Robertbolt97/Claw-with-OT-2/OT-2 code/README.md

The files situated within in this folder are the ones that are loaded onto jupyter notebook of opentrons OT-2 and are split into three sections; grabbing, releasing and overall code

Overall scipting (utilising grabbing and releasing scripts):
1) Movement_trial_empty
2) Movement_trial_heavy
3) Movement_trial_heavy_height
4) Claw_falcon_tube

Grabbing Scripts:
1) Claw_grab_light
2) Claw_grab_heavy
3) Claw_grab_heavy_height

Releasing Scripts
1) Claw_release
2) Claw_release_heavy
