Robertbolt97/Claw-with-OT-2/Labware Weights.pdf

# Labware Weights: Empty and Filled

Labware | Empty Weight / g | Full Weight / g
Corning 96 Well Plate 360 µL Flat | 42 | 77
Thermo Scientific Nunc 96 Well Plate 1300 µL | 100 | 210
NEST 12 Well Reservoir 15 mL | 79 | 248
Tip rack 20 uL | 168 | 173
Tip rack 300 uL | 162 | 209
Agilent 1 Well Reservoir 290 mL (225 mL) | 53 | 286
Custom 24 x LCMS vials | 61 | 163
