Robertbolt97/Claw-with-OT-2/Bill of materials table.pdf

# Bill of materials table

Part No. | Part Name | Quantity | Category | Cost/£ | Source
1 | Raspberry pi zero wh | 1 | Microcontroller | 12.60 | Onecall - Farnell
2 | Servo HAT | 1 | Servo motor module | 12.99 | Amazon
3 | Servo Motor | 2 | Servo motor | 8.28 | Onecall - Farnell
4 | Servo Extension Cable Cord | 1 | Servo motor extension wire | 9.99 | Amazon
5 | Servo Plug Male Female Connector Crimp Pin Kit | 1 | Servo motor extension wire | 8.99 | Amazon
6 | USB To TTL RS232 Module Converter | 1 | Serial adapter | 6.99 | Amazon
7 | None slip tape | 1 | Grip tape for claw | 6.28 | Amazon
8 | 3D filament (750 g / 96 m) | 1 | PLA for print of the claw design | 33.67 / (13.51)* | Onecall - Farnell
9 | Hex Socket Button Screw | 4 | M3 x 8 mm | 0.20 | Onecall - Farnell
10 | Hex Socket Button Screw | 4 | M3 x 6 mm | 0.44 | RS Pro
11 | Square nut | 8 | M3 | 0.72 | Onecall - Farnell
12 | Self-tapping screws | 2 | 4 x 3/8" (2.9 x 9.5mm) | 0.12 | RS Pro
13 | Self-tapping screws | 2 | 4 x 1/2" (2.9 x 13mm) | 0.17 | RS Pro
14 | Pan head slotted screw | 1 | M3 x 20 mm | 0.03 | Onecall - Farnell
15 | Hex nut | 1 | M3 | 0.03 | Onecall - Farnell

Total Cost = £101.50 (£81.34)*

*Cost of filament used

# Links for Consumptions

Raspberry pi: RASPBERRY-PI ZERO WH V2 (https://uk.farnell.com/raspberry-pi/sc0721/rpi-zero-2w-brd-w-header-arm-cortex/dp/4531088)

Servo HAT: Waveshare Servo Driver HAT Expansion Board, Compatible with Raspberry Pi, 12-Bit, I2C Interface, Straight Pinheader, Up to 16-Channel Servo/PWM Outputs (https://www.amazon.co.uk/Waveshare-16-Channel-Servo-Driver-HAT/dp/B07GYFTKZD)

Servo Motor: Servo Motor, Continuous Rotation (https://uk.farnell.com/multicomp-pro/mp-708-0002/servo-motor-6v-130rpm-360deg-rotation/dp/3359812)

Servo Extension Cable: Servo Extension Cable Cord Connector Lead Wire 22AWG Servo Receiver Wire (https://www.amazon.co.uk/sourcing-map-Extension-Connector-Receiver/dp/B09BQVJHM5)

Servo Plug Male Female Connector Crimp Pin Kit: 30 Sets Servo Plug Male Female Connector Crimp Pin Kit Compatible Futaba for Hitec Spektrum RC (https://www.amazon.co.uk/Female-Connector-Compatible-Futaba-Spektrum/dp/B07PJK2WGX)

USB To TTL RS232 Module Converter: USB To TTL Serial Port Download Cable (https://www.amazon.co.uk/Serial-Download-PL2303TA-Converter-Adapter/dp/B08HS9M3P9)

None slip tape: 1 Roll Clear Anti Slip Tape Non Slip Safety Grip Tape Rubber Self Adhesive Tape (https://www.amazon.co.uk/Safety-Adhesive-Bathtub-Kitchen-Without/dp/B0DDC31DG3)

3D filament: 3D Printer Filament, 2.85mm Dia, Black, PLA, 145 to 160°C, 750 g (https://uk.farnell.com/ultimaker/202300/3d-printer-filament-pla-2-85mm/dp/2992600)

Hex Socket Button Screw (M3 x 8 mm): Socket Screw, Button Head Hex, Stainless Steel A2, 8 mm, M3 (https://uk.farnell.com/tr-fastenings/m38-bha2mcs100/screw-button-head-hex-socket-ss/dp/1420715)

Hex Socket Button Screw (M3 x 6 mm): RS PRO Black, Self-Colour Steel Hex Socket Button Screw, ISO 7380, M3 x 6mm (https://uk.rs-online.com/web/p/socket-screws/8229098?gb=s)

Square nut (M3): Press Nut, Square, Bright Zinc Plated, M3 (https://uk.farnell.com/tr-fastenings/m3-sqst-z100bs4183/press-nut-square-bzp-m3-pk100/dp/1419469?cfm=true)

Self-tapping screws - 4 x 3/8": RS PRO Plain Stainless Steel Pan Head Self Tapping Screw, N°4 x 3/8in Long 9.5mm Long (https://uk.rs-online.com/web/p/self-tapping-screws/0521541?gb=s)

Self-tapping screws - 4 x 1/2": RS PRO Plain Stainless Steel Pan Head Self Tapping Screw, N°4 x 1/2in Long 13mm Long (https://uk.rs-online.com/web/p/self-tapping-screws/0521557?gb=s)

Pan head slotted screw (M3 x 20 mm): M3 x 20mm Slotted Countersunk Head ZP Machine Screws (https://cpc.farnell.com/unbranded/cs3m20/screw-csk-slot-3m-x-20mm-100pk/dp/FNCS3M20?gad_source=1)

Hex nut (M3): Hex Nut, Stainless Steel A2, M3 (https://uk.farnell.com/multicomp-pro/mp007412/nut-hex-stainless-steel-a2-m3/dp/3755189)
