Robertbolt97/Claw-with-OT-2/CAD_Files/9)Slider-main_body_gear.stl

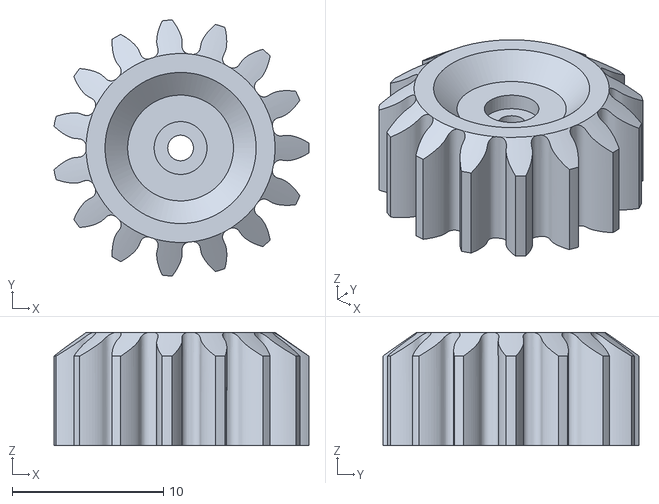
[picture p6: CAD file, 2025-03-10]
CAD_Files/9)Slider-main_body_gear.stl
16.9 x 17.0 x 7.50
