Robertbolt97/Claw-with-OT-2/CAD_Files/11) Front_main_body.stl

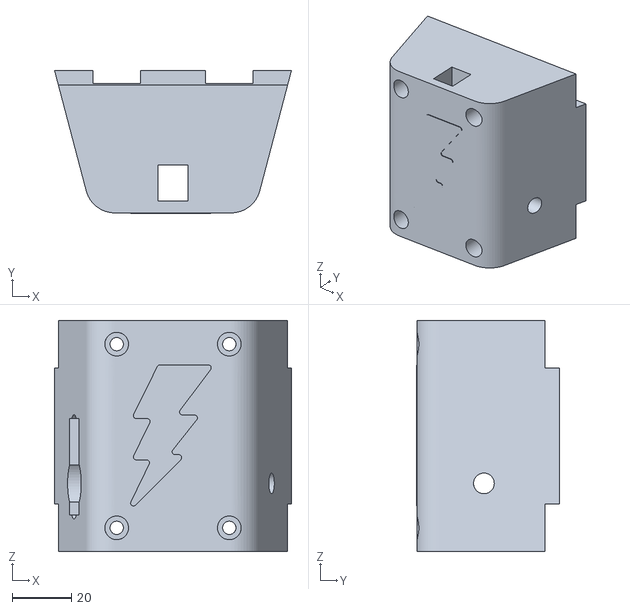
[picture p7: CAD file, 2025-03-10]
CAD_Files/11) Front_main_body.stl
80.0 x 48.4 x 78.0
