Robertbolt97/Claw-with-OT-2/CAD_Files/4)Slider_main_body.stl

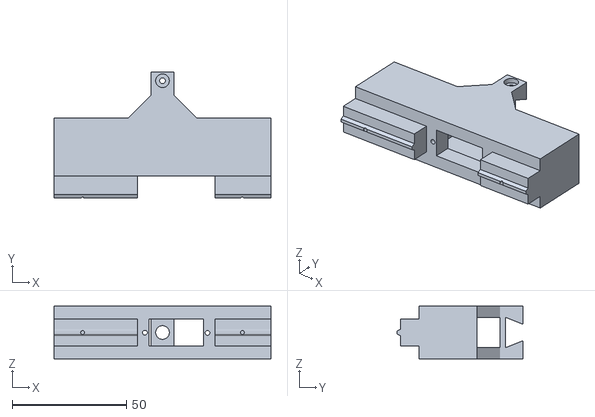
[picture p8: CAD file, 2025-03-10]
CAD_Files/4)Slider_main_body.stl
95.0 x 55.0 x 23.0
