Robertbolt97/Claw-with-OT-2/CAD_Files/6)Front_Slider.stl

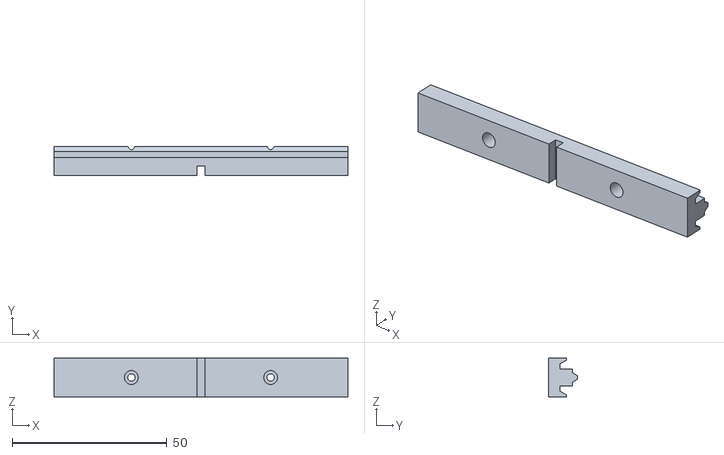
[picture p9: CAD file, 2025-03-10]
CAD_Files/6)Front_Slider.stl
95.0 x 9.25 x 12.5
