Robertbolt97/Claw-with-OT-2/CAD_Files/1)Support_bracket_brace.stl

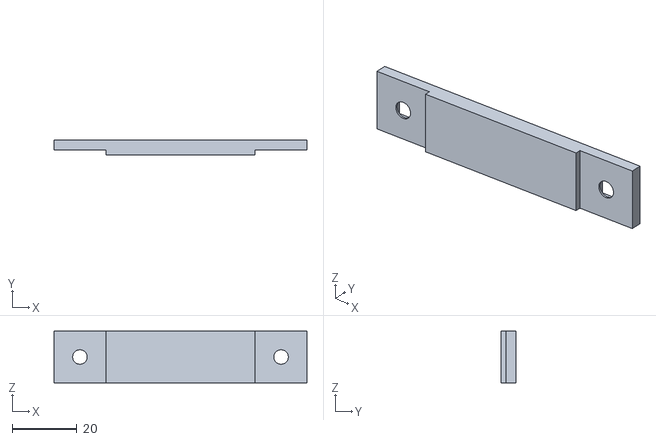
[picture p10: CAD file, 2025-03-10]
CAD_Files/1)Support_bracket_brace.stl
78.0 x 4.50 x 16.0
