Robertbolt97/Claw-with-OT-2/CAD_Files/10)Lowering_arm_gear.stl

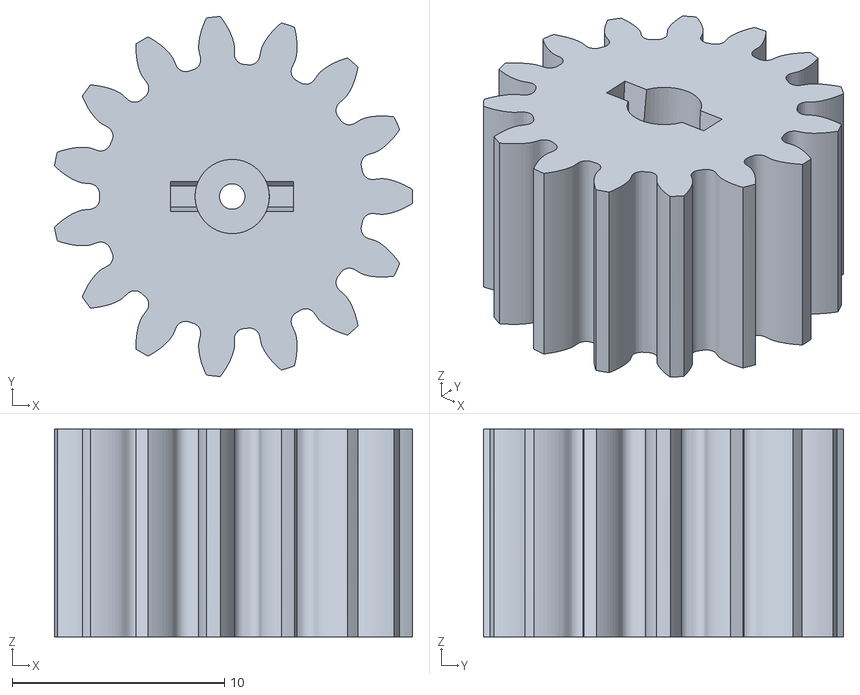
[picture p11: CAD file, 2025-03-10]
CAD_Files/10)Lowering_arm_gear.stl
16.9 x 17.0 x 9.80
