Robertbolt97/Claw-with-OT-2/CAD_Files/2)Support_bracket.stl

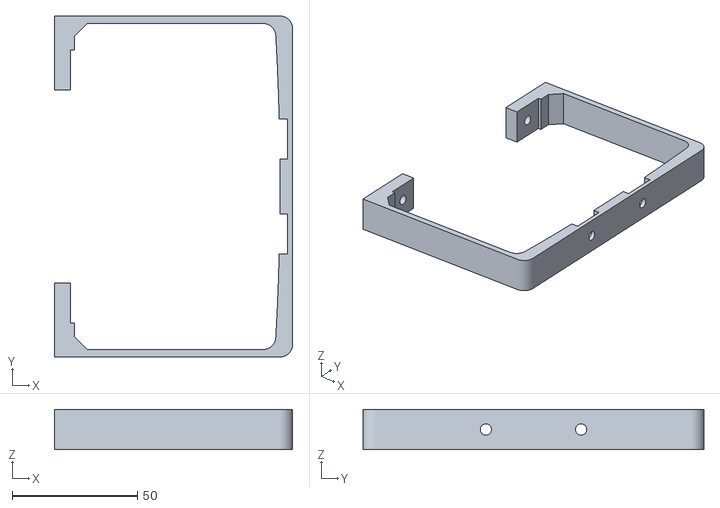
[picture p12: CAD file, 2025-03-10]
CAD_Files/2)Support_bracket.stl
95.0 x 136.0 x 16.0
