Robertbolt97/Claw-with-OT-2/CAD_Files/5)Back_slider.stl

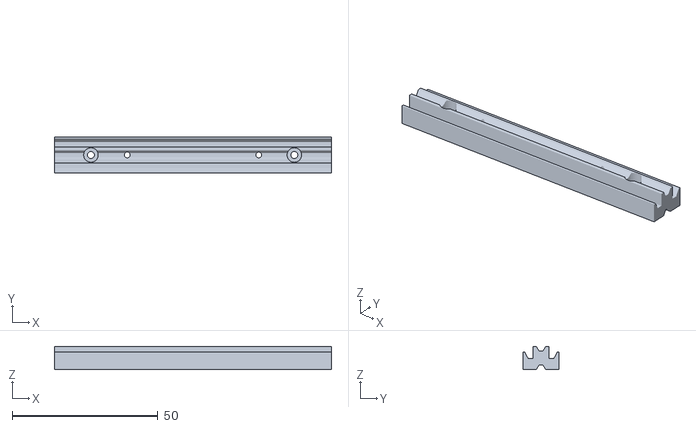
[picture p13: CAD file, 2025-03-10]
CAD_Files/5)Back_slider.stl
95.0 x 12.5 x 8.00
