Robertbolt97/Claw-with-OT-2/CAD_Files/8)Stopper.stl

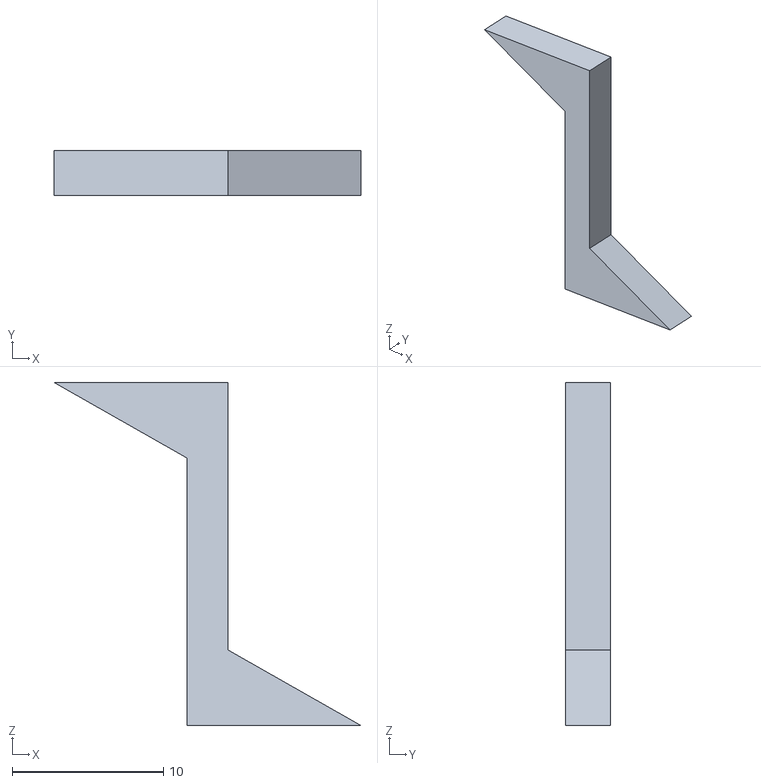
[picture p14: CAD file, 2025-03-10]
CAD_Files/8)Stopper.stl
20.3 x 3.00 x 22.7
