Robertbolt97/Claw-with-OT-2/CAD_Files/3)Lowering_arm.stl

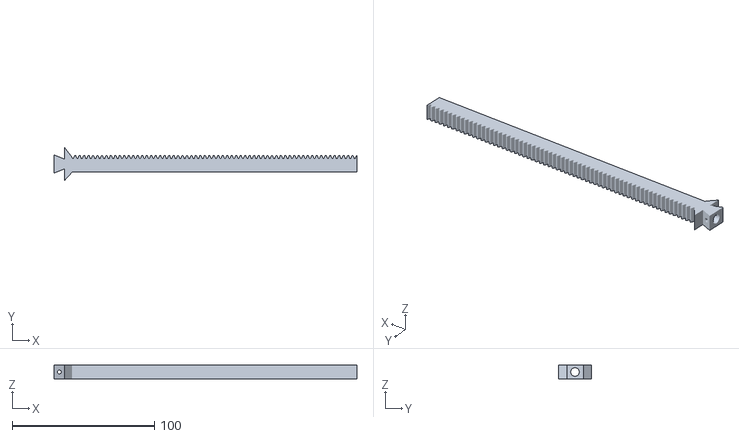
[picture p15: CAD file, 2025-03-10]
CAD_Files/3)Lowering_arm.stl
212.8 x 23.0 x 10.0
