Robertbolt97/Claw-with-OT-2/CAD_Files/7)Sliding_fork_reinforce.stl

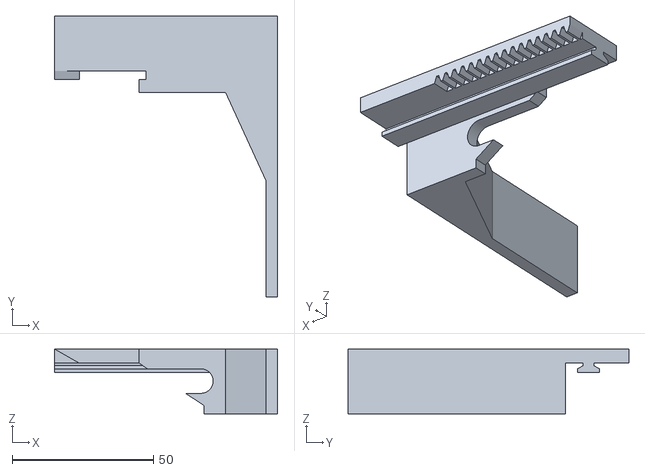
[picture p16: CAD file, 2025-03-10]
CAD_Files/7)Sliding_fork_reinforce.stl
79.0 x 99.5 x 23.0
