Robertbolt97/Claw-with-OT-2/Images/Step_5A.jpg

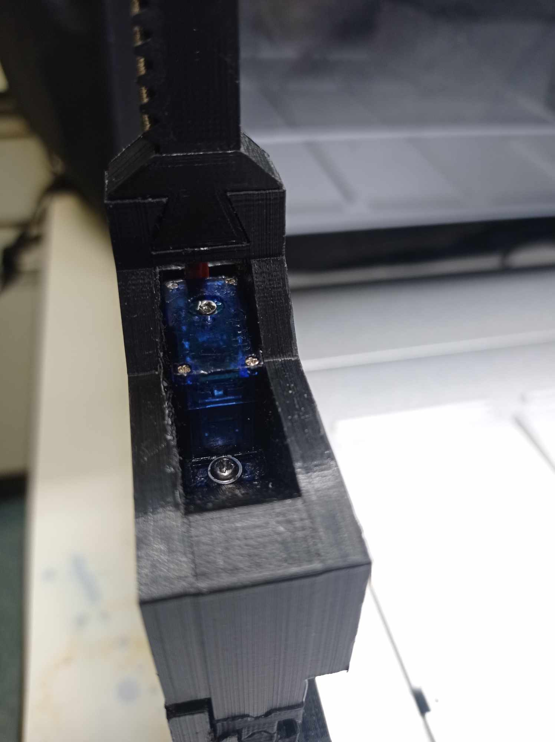
Images/Step_5A.jpg
