Robertbolt97/Claw-with-OT-2/(commit log)

2025-03-10 Create 3D printing files
2025-03-10 Update and rename 3D printing files to README.md
2025-03-10 Rename Claw numbered.jpg to Claw_numbered.jpg
2025-03-10 Create Videos of the claw
2025-03-17 Create Assembly
2025-03-17 Rename Back slider.stl to Back slider.stl
    [Back slider.stl]
2025-03-17 Rename Front Slider.stl to Front Slider.stl
    [Front Slider.stl]
2025-03-17 Rename Front main body.stl to Front main body.stl
    [Front main body.stl]
2025-03-17 Rename Lowering arm gear.stl to Lowering arm gear.stl
    [Lowering arm gear.stl]
2025-03-17 Rename Lowering arm.stl to Lowering arm.stl
    [Lowering arm.stl]
2025-03-17 Rename Slider main body gear.stl to Slider main body gear.stl
    [Slider main body gear.stl]
2025-03-17 Rename Slider main body.stl to Slider main body.stl
    [Slider main body.stl]
2025-03-17 Rename Sliding fork reinforce.stl to Sliding fork reinforce.stl
    [Sliding fork reinforce.stl]
2025-03-17 Rename Support bracket brace.stl to Support bracket brace.stl
    [Support bracket brace.stl]
2025-03-17 Rename Support bracket.stl to Support bracket.stl
    [Support bracket.stl]
2025-03-17 Rename Back slider.stl to 5)Back_slider.stl
    [5)Back_slider.stl]
2025-03-17 Rename Front Slider.stl to 6)Front_Slider.stl
    [6)Front_Slider.stl]
2025-03-17 Rename Front main body.stl to 11) Front_main_body.stl
    [11) Front_main_body.stl]
2025-03-17 Rename Lowering arm gear.stl to 10)Lowering_arm_gear.stl
    [10)Lowering_arm_gear.stl]
2025-03-17 Rename Lowering arm.stl to 3)Lowering_arm.stl
    [3)Lowering_arm.stl]
2025-03-17 Rename Slider main body gear.stl to 9)Slider-main_body_gear.stl
    [9)Slider-main_body_gear.stl]
2025-03-17 Rename Slider main body.stl to 4)Slider_main_body.stl
    [4)Slider_main_body.stl]
2025-03-17 Rename Sliding fork reinforce.stl to 7)Sliding_fork_reinforce.stl
    [7)Sliding_fork_reinforce.stl]
2025-03-17 Rename Support bracket brace.stl to 1)Support_bracket_brace.stl
    [1)Support_bracket_brace.stl]
2025-03-17 Rename Support bracket.stl to 2)Support_bracket.stl
    [2)Support_bracket.stl]
